GiovaGG/haptic-paddle-teleoperation-/docs/simulink-screenshots.md

# Simulink model screenshots — from the thesis

These are **authentic screenshots embedded in Giovanni Gentiloni Silveri's bachelor's thesis** (2026). They illustrate the design and development stages. **They are not editable `.slx` models, source code, or proof of plug-and-play reproducibility.** Figure descriptions follow the thesis's technical narrative.

| Processing and embedded control | Master–slave integration |
| --- | --- |
| **ADC → angle (thesis PDF p. 13)**<br>Simulink analog-to-radian subsystem | **Servo mapping and filtering (p. 59)**<br>Servo angle mapping and first-order discrete low-pass filter |
| **Angular velocity observer (p. 15)**<br>Simulink proportional velocity observer | **HC-SR04 sensor chain (p. 61)**<br>Arduino ultrasonic distance and servo processing in Simulink |
| **PWM preprocessing (p. 16)**<br>Two signed PWM motor-control channels | **Directional obstacle logic (p. 66)**<br>Position and distance based obstacle direction flag |
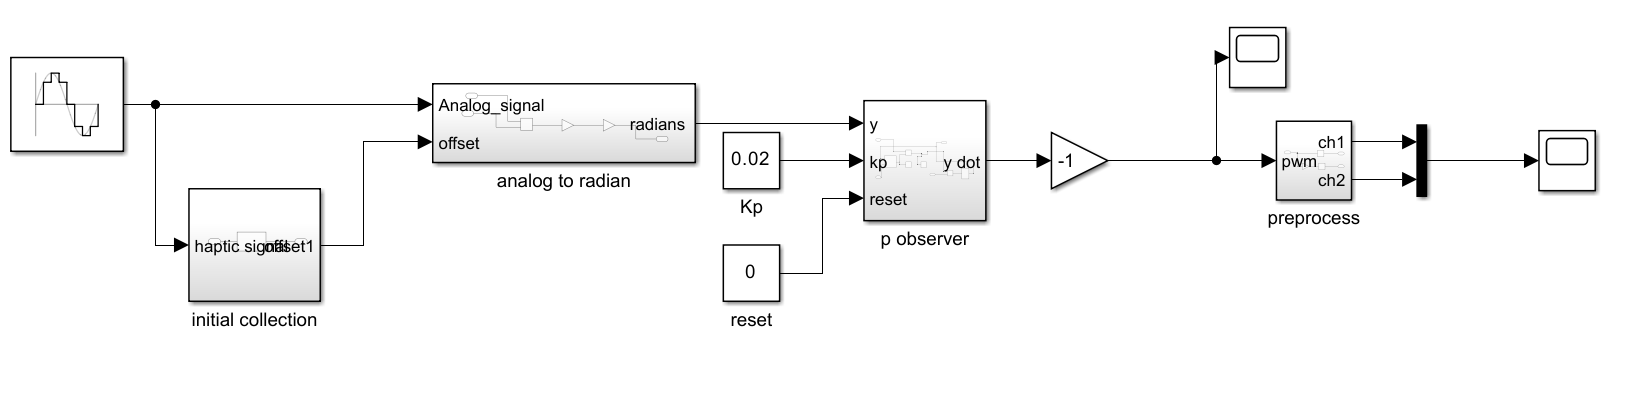
[picture p12: assets/simulink/baseline-controller.png]
Test03 Simulink control system
| **Original Simulink controller (p. 23)**<br> | **Direction-selective PWM gains (p. 74)**<br>Direction-dependent damping control in PWM paths |
| **Arduino paddle integration (p. 41)**<br>Arduino paddle hardware integration | **Final integrated model (p. 78)**<br>Final complete Simulink teleoperation and haptic controller model |

**Reading the architecture:** the master paddle is sensed at A0; its angular position drives both the damping controller and the servo reference. The slave servo is commanded through pin D9. The HC-SR04's distance measurement enters a filtered proximity-feedback channel; a latched directional flag controls which PWM branch receives additional damping.

For a detailed explanation of the model's design, see [Control algorithms](control-algorithms.md). The source `.slx` project remains to be added by the author.
