GiovaGG/haptic-paddle-teleoperation-/assets/paddle-movement-02.jpg

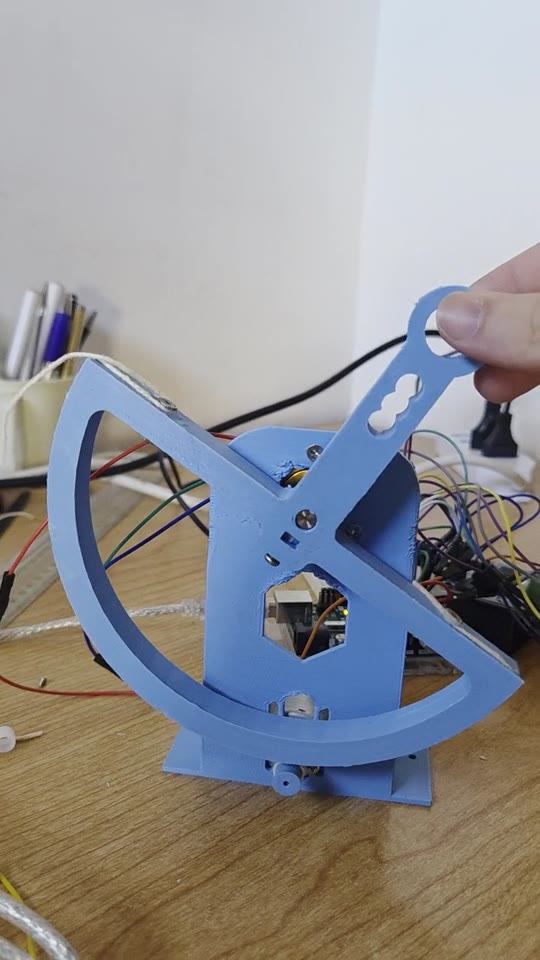
assets/paddle-movement-02.jpg
